supunchira/Knitting-machine-monitoring-system/README.md

# Knitting-machine-monitoring-system
Training project
